PPKoller/MAX31865x10/ArgonCube_2x2/pt100_4-point.jpg

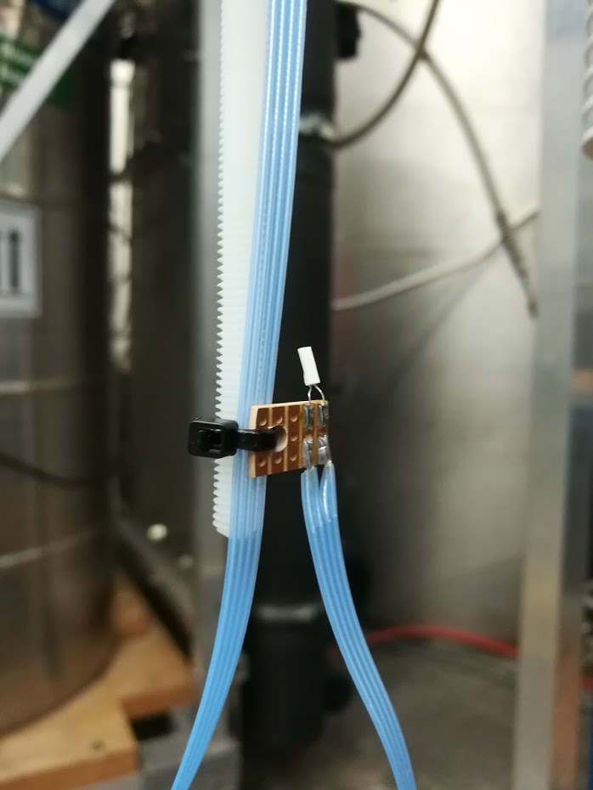
ArgonCube_2x2/pt100_4-point.jpg
