PPKoller/MAX31865x10/ArgonCube_2x2/pt100_backplate_drawings.jpg

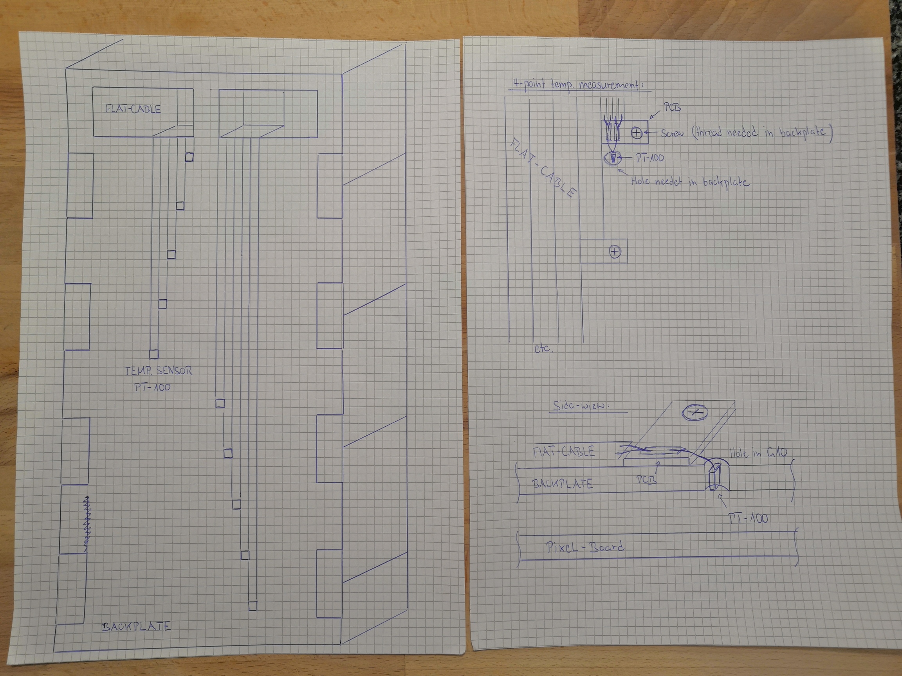
ArgonCube_2x2/pt100_backplate_drawings.jpg
