PPKoller/MAX31865x10/README.md

# MAX31865x10
PCB for serial 4-point measurement of ten PT-100 temperature sensors using Raspberry Pi.
