PPKoller/MAX31865x10/(list of files, cad)

Other CAD files:
Adafruit-MAX31865-PCB/kicad-footprints/Sources/Package_SON/X2SON-4_1x1mm_P0.65mm.fcstd
Adafruit-MAX31865-PCB/kicad-footprints/Sources/Package_TO_SOT_THT/sod-70.fcstd
MAX31865_x10_PCB/kicad-footprints/Sources/Package_SON/X2SON-4_1x1mm_P0.65mm.fcstd
MAX31865_x10_PCB/kicad-footprints/Sources/Package_TO_SOT_THT/sod-70_P5.08mm.fcstd
Adafruit-MAX31865-PCB/kicad-footprints/Sources/Package_TO_SOT_THT/sod-70_P5.08mm.fcstd
MAX31865_x10_PCB/kicad-footprints/Sources/Package_TO_SOT_THT/sod-70.fcstd
