PPKoller/MAX31865x10/MAX31865_x10_PCB/MAX31865_x10_PCB.kicad_pcb

## KiCad design MAX31865_x10_PCB/MAX31865_x10_PCB.kicad_pcb (2020-02-25)

Schematic: power.sch

Parts:
C1, C2: 10uF; 0805-NO
J1: Conn_02x20_Odd_Even; PinHeader_2x20_P2.54mm_Vertical
JP1: Jumper_3_Bridged12; PinHeader_1x03_P2.54mm_Vertical
U1, U2, U3, U4: MOUNTINGHOLE3.0; MountingHole_3.2mm_M3
U5: MIC5225-3.3; SOT23-5

Connections:
CLK_5V: J1.23; also elsewhere on the board
CS0_5V: J1.40; also elsewhere on the board
CS1_5V: J1.38; also elsewhere on the board
CS2_5V: J1.36; also elsewhere on the board
CS3_5V: J1.32; also elsewhere on the board
CS4_5V: J1.26; also elsewhere on the board
CS5_5V: J1.24; also elsewhere on the board
CS6_5V: J1.22; also elsewhere on the board
CS7_5V: J1.18; also elsewhere on the board
CS8_5V: J1.16; also elsewhere on the board
CS9_5V: J1.12; also elsewhere on the board
EXT_3V3: J1.1, JP1.3 (B)
EXT_5V: C1.1, J1.2, U5.1 (IN), U5.3 (EN)
GND: C1.2, C2.2, J1.6, U5.2 (GND); also elsewhere on the board
RDY: J1.15; also elsewhere on the board
SDI_5V: J1.19; also elsewhere on the board
SDO: J1.21; also elsewhere on the board
VDD: C2.1, JP1.1 (A), JP1.2 (C), U5.5 (OUT); also elsewhere on the board

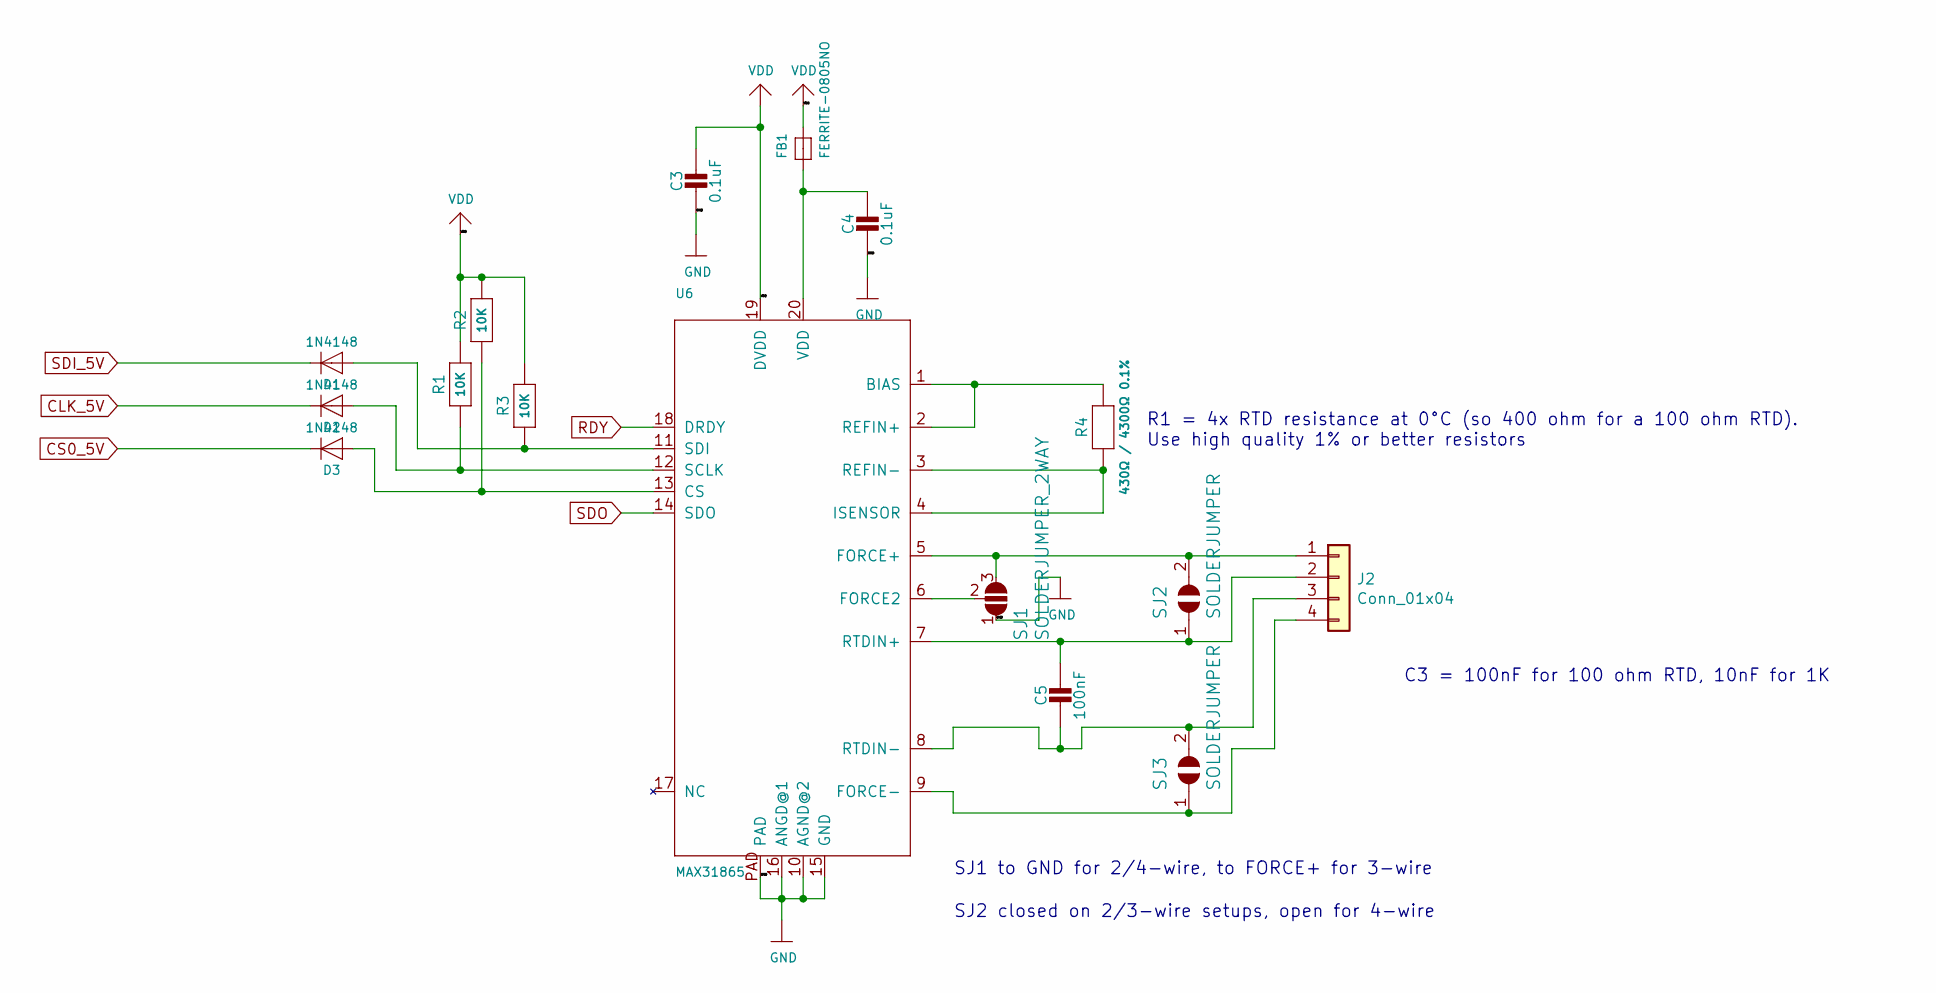
[picture p18: schematic max31865_00.sch]

Parts:
C3, C4: 0.1uF; 0805-NO
C5: 100nF; 0805-NO
D1, D2, D3: 1N4148; SOD-323
FB1: FERRITE-0805NO; 0805-NO
J2: Conn_01x04; TerminalBlock_4Ucon_1x04_P3.50mm_Horizontal
R1, R2, R3: 10K; 0805-NO
R4: 430Ω / 4300Ω 0.1%; 0805-NO
SJ1: SOLDERJUMPER_2WAY; SOLDERJUMPER_2WAY_OPEN_NOPASTE
SJ2, SJ3: SOLDERJUMPER; SOLDERJUMPER_ARROW_NOPASTE
U6: MAX31865; QFN20_4MM_0.65MM

Connections:
CLK_5V: D2.C; also elsewhere on the board
CS0_5V: D3.C; also elsewhere on the board
GND: C3.2, C4.2, SJ1.1, U6.10 (AGND@2), U6.15 (GND), U6.16 (ANGD@1), U6.PAD; also elsewhere on the board
unnamed: C4.1, FB1.1, U6.20 (VDD)
unnamed: C5.1, J2.2, SJ2.1, U6.7 (RTDIN+)
unnamed: C5.2, J2.3, SJ3.2, U6.8 (RTDIN-)
unnamed: D1.A, R3.1, U6.11 (SDI)
unnamed: D2.A, R1.1, U6.12 (SCLK)
unnamed: D3.A, R2.1, U6.13 (CS)
unnamed: J2.1, SJ1.3, SJ2.2, U6.5 (FORCE+)
unnamed: J2.4, SJ3.1, U6.9 (FORCE-)
unnamed: R4.1, U6.3 (REFIN-), U6.4 (ISENSOR)
unnamed: R4.2, U6.1 (BIAS), U6.2 (REFIN+)
unnamed: SJ1.2, U6.6 (FORCE2)
RDY: U6.18 (DRDY); also elsewhere on the board
SDI_5V: D1.C; also elsewhere on the board
SDO: U6.14 (SDO); also elsewhere on the board
VDD: C3.1, FB1.2, R1.2, R2.2, R3.2, U6.19 (DVDD); also elsewhere on the board

Notes on the sheet:
C3 = 100nF for 100 ohm RTD, 10nF for 1K
R1 = 4x RTD resistance at 0°C (so 400 ohm for a 100 ohm RTD). Use high quality 1% or better resistors
SJ1 to GND for 2/4-wire, to FORCE+ for 3-wire
SJ2 closed on 2/3-wire setups, open for 4-wire

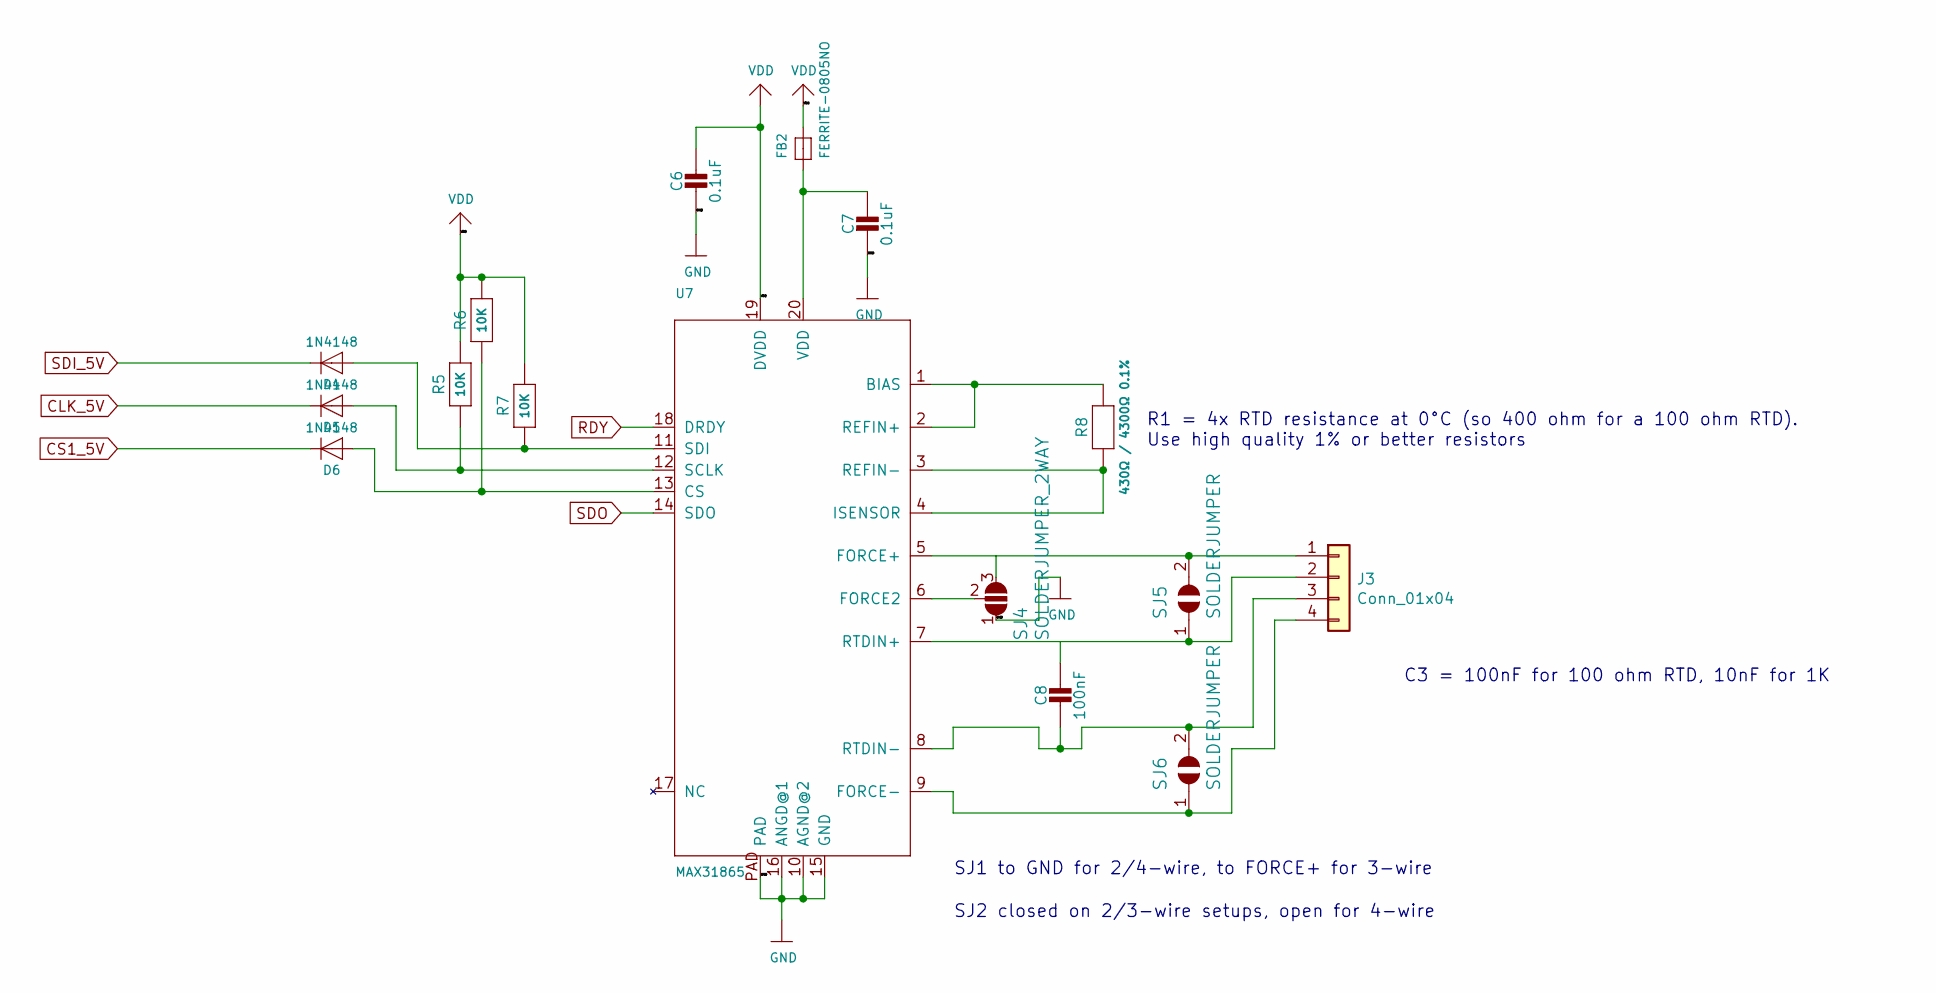
[picture p19: schematic max31865_01.sch]

Parts:
C6, C7: 0.1uF; 0805-NO
C8: 100nF; 0805-NO
D4, D5, D6: 1N4148; SOD-323
FB2: FERRITE-0805NO; 0805-NO
J3: Conn_01x04; TerminalBlock_4Ucon_1x04_P3.50mm_Horizontal
R5, R6, R7: 10K; 0805-NO
R8: 430Ω / 4300Ω 0.1%; 0805-NO
SJ4: SOLDERJUMPER_2WAY; SOLDERJUMPER_2WAY_OPEN_NOPASTE
SJ5, SJ6: SOLDERJUMPER; SOLDERJUMPER_ARROW_NOPASTE
U7: MAX31865; QFN20_4MM_0.65MM

Connections:
CLK_5V: D5.C; also elsewhere on the board
CS1_5V: D6.C; also elsewhere on the board
GND: C6.2, C7.2, SJ4.1, U7.10 (AGND@2), U7.15 (GND), U7.16 (ANGD@1), U7.PAD; also elsewhere on the board
unnamed: C7.1, FB2.1, U7.20 (VDD)
unnamed: C8.1, J3.2, SJ5.1, U7.7 (RTDIN+)
unnamed: C8.2, J3.3, SJ6.2, U7.8 (RTDIN-)
unnamed: D4.A, R7.1, U7.11 (SDI)
unnamed: D5.A, R5.1, U7.12 (SCLK)
unnamed: D6.A, R6.1, U7.13 (CS)
unnamed: J3.1, SJ4.3, SJ5.2, U7.5 (FORCE+)
unnamed: J3.4, SJ6.1, U7.9 (FORCE-)
unnamed: R8.1, U7.3 (REFIN-), U7.4 (ISENSOR)
unnamed: R8.2, U7.1 (BIAS), U7.2 (REFIN+)
unnamed: SJ4.2, U7.6 (FORCE2)
RDY: U7.18 (DRDY); also elsewhere on the board
SDI_5V: D4.C; also elsewhere on the board
SDO: U7.14 (SDO); also elsewhere on the board
VDD: C6.1, FB2.2, R5.2, R6.2, R7.2, U7.19 (DVDD); also elsewhere on the board

Notes on the sheet:
C3 = 100nF for 100 ohm RTD, 10nF for 1K
R1 = 4x RTD resistance at 0°C (so 400 ohm for a 100 ohm RTD). Use high quality 1% or better resistors
SJ1 to GND for 2/4-wire, to FORCE+ for 3-wire
SJ2 closed on 2/3-wire setups, open for 4-wire

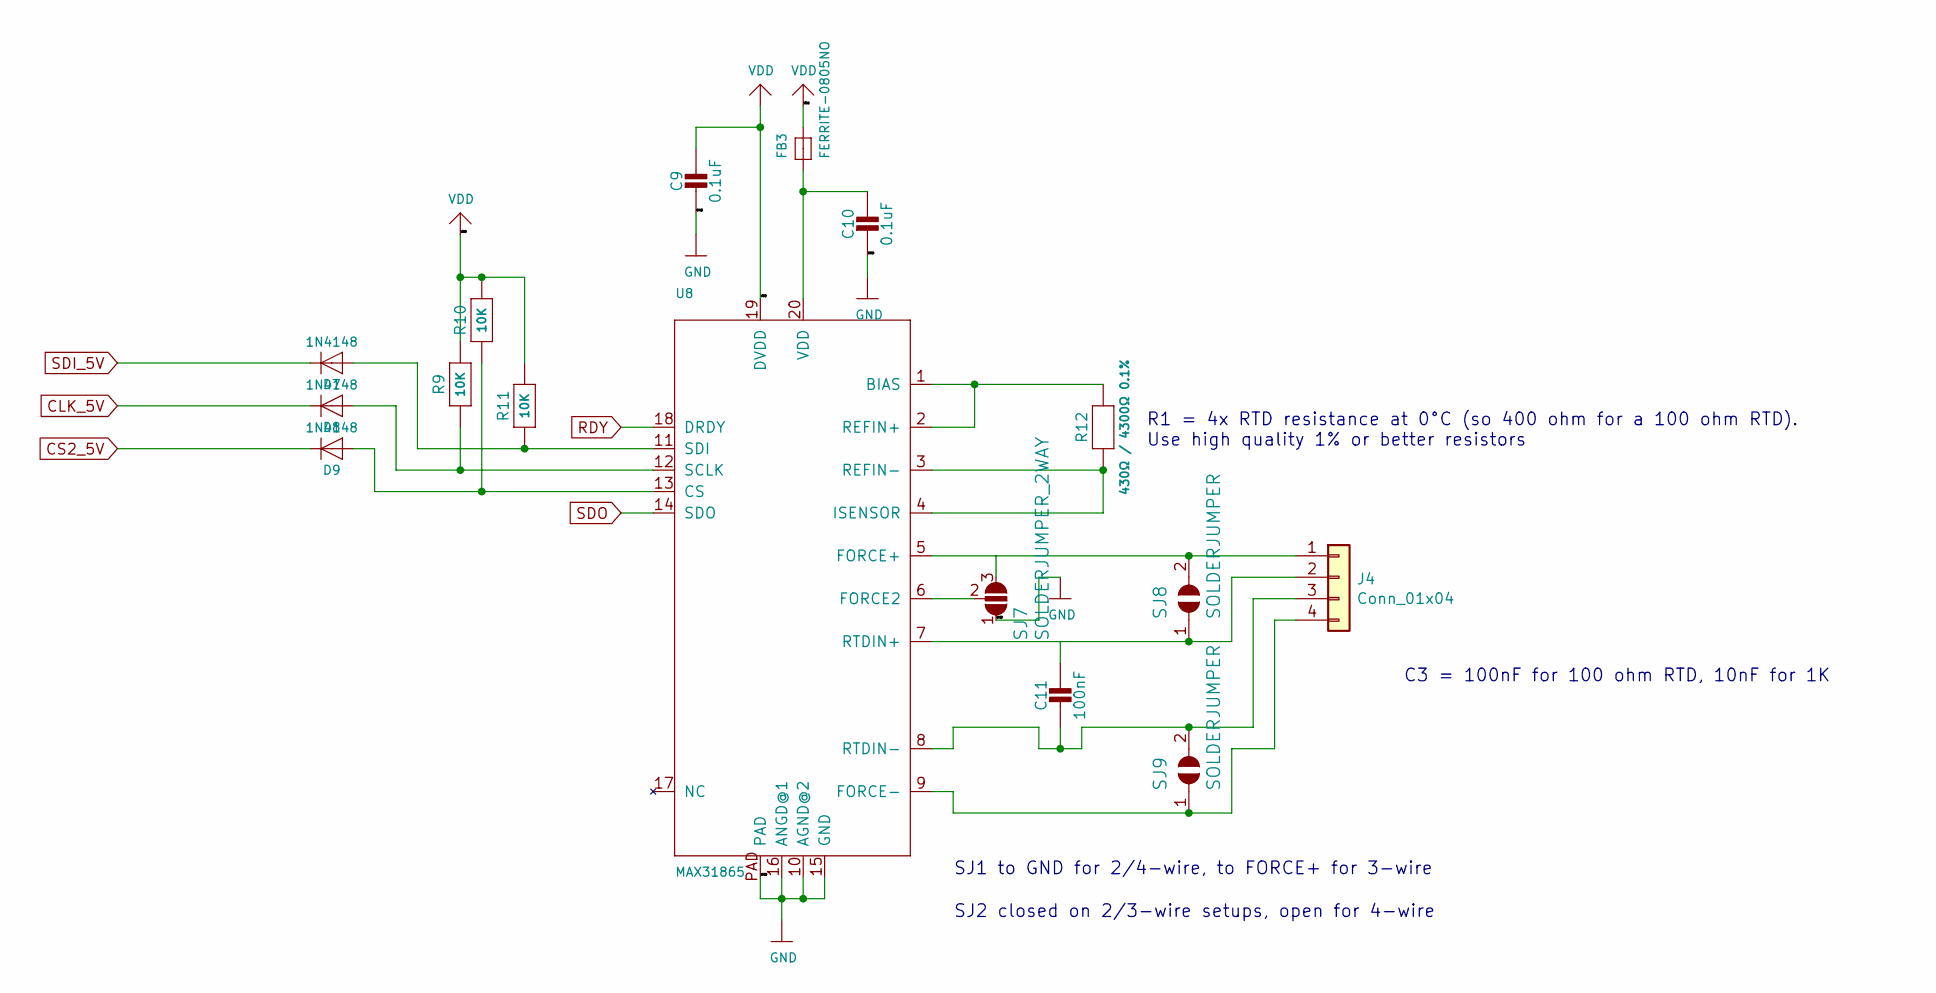
[picture p20: schematic max31865_02.sch]

Parts:
C9, C10: 0.1uF; 0805-NO
C11: 100nF; 0805-NO
D7, D8, D9: 1N4148; SOD-323
FB3: FERRITE-0805NO; 0805-NO
J4: Conn_01x04; TerminalBlock_4Ucon_1x04_P3.50mm_Horizontal
R9, R10, R11: 10K; 0805-NO
R12: 430Ω / 4300Ω 0.1%; 0805-NO
SJ7: SOLDERJUMPER_2WAY; SOLDERJUMPER_2WAY_OPEN_NOPASTE
SJ8, SJ9: SOLDERJUMPER; SOLDERJUMPER_ARROW_NOPASTE
U8: MAX31865; QFN20_4MM_0.65MM

Connections:
CLK_5V: D8.C; also elsewhere on the board
CS2_5V: D9.C; also elsewhere on the board
GND: C9.2, C10.2, SJ7.1, U8.10 (AGND@2), U8.15 (GND), U8.16 (ANGD@1), U8.PAD; also elsewhere on the board
unnamed: C10.1, FB3.1, U8.20 (VDD)
unnamed: C11.1, J4.2, SJ8.1, U8.7 (RTDIN+)
unnamed: C11.2, J4.3, SJ9.2, U8.8 (RTDIN-)
unnamed: D7.A, R11.1, U8.11 (SDI)
unnamed: D8.A, R9.1, U8.12 (SCLK)
unnamed: D9.A, R10.1, U8.13 (CS)
unnamed: J4.1, SJ7.3, SJ8.2, U8.5 (FORCE+)
unnamed: J4.4, SJ9.1, U8.9 (FORCE-)
unnamed: R12.1, U8.3 (REFIN-), U8.4 (ISENSOR)
unnamed: R12.2, U8.1 (BIAS), U8.2 (REFIN+)
unnamed: SJ7.2, U8.6 (FORCE2)
RDY: U8.18 (DRDY); also elsewhere on the board
SDI_5V: D7.C; also elsewhere on the board
SDO: U8.14 (SDO); also elsewhere on the board
VDD: C9.1, FB3.2, R9.2, R10.2, R11.2, U8.19 (DVDD); also elsewhere on the board

Notes on the sheet:
C3 = 100nF for 100 ohm RTD, 10nF for 1K
R1 = 4x RTD resistance at 0°C (so 400 ohm for a 100 ohm RTD). Use high quality 1% or better resistors
SJ1 to GND for 2/4-wire, to FORCE+ for 3-wire
SJ2 closed on 2/3-wire setups, open for 4-wire

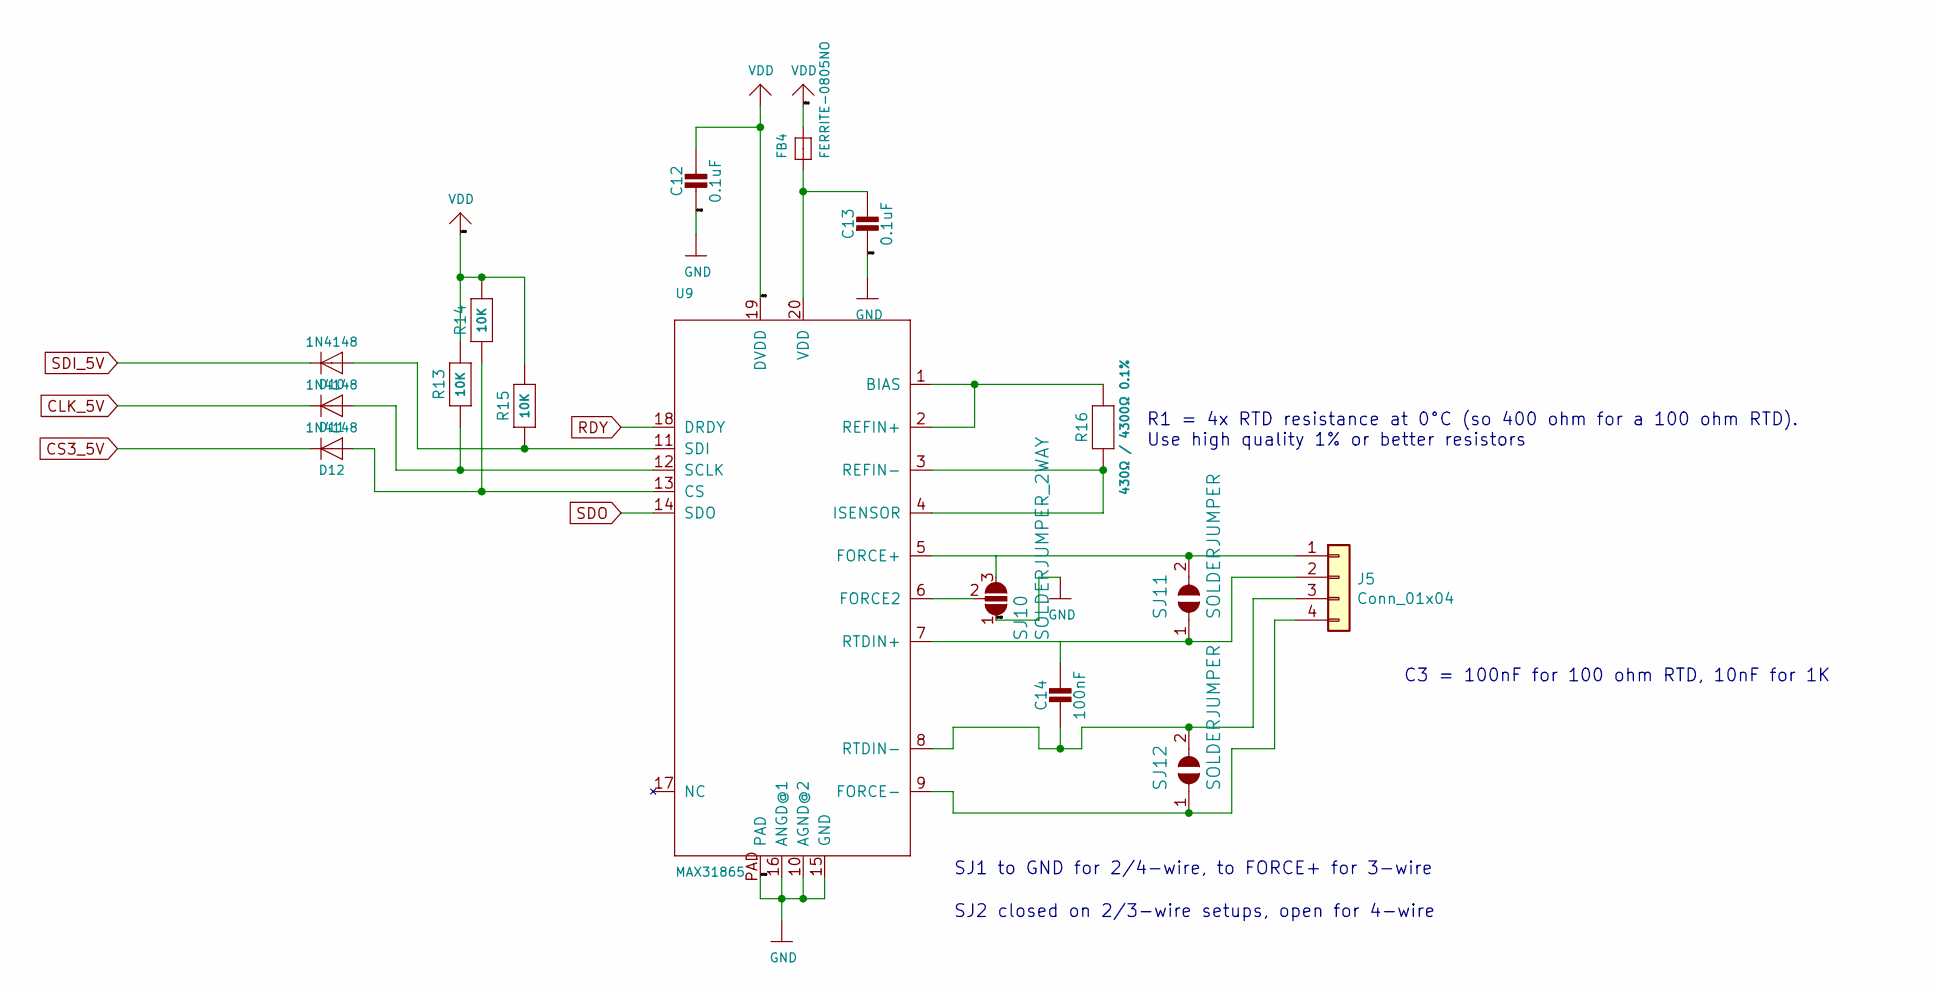
[picture p21: schematic max31865_03.sch]

Parts:
C12, C13: 0.1uF; 0805-NO
C14: 100nF; 0805-NO
D10, D11, D12: 1N4148; SOD-323
FB4: FERRITE-0805NO; 0805-NO
J5: Conn_01x04; TerminalBlock_4Ucon_1x04_P3.50mm_Horizontal
R13, R14, R15: 10K; 0805-NO
R16: 430Ω / 4300Ω 0.1%; 0805-NO
SJ10: SOLDERJUMPER_2WAY; SOLDERJUMPER_2WAY_OPEN_NOPASTE
SJ11, SJ12: SOLDERJUMPER; SOLDERJUMPER_ARROW_NOPASTE
U9: MAX31865; QFN20_4MM_0.65MM

Connections:
CLK_5V: D11.C; also elsewhere on the board
CS3_5V: D12.C; also elsewhere on the board
GND: C12.2, C13.2, SJ10.1, U9.10 (AGND@2), U9.15 (GND), U9.16 (ANGD@1), U9.PAD; also elsewhere on the board
unnamed: C13.1, FB4.1, U9.20 (VDD)
unnamed: C14.1, J5.2, SJ11.1, U9.7 (RTDIN+)
unnamed: C14.2, J5.3, SJ12.2, U9.8 (RTDIN-)
unnamed: D10.A, R15.1, U9.11 (SDI)
unnamed: D11.A, R13.1, U9.12 (SCLK)
unnamed: D12.A, R14.1, U9.13 (CS)
unnamed: J5.1, SJ10.3, SJ11.2, U9.5 (FORCE+)
unnamed: J5.4, SJ12.1, U9.9 (FORCE-)
unnamed: R16.1, U9.3 (REFIN-), U9.4 (ISENSOR)
unnamed: R16.2, U9.1 (BIAS), U9.2 (REFIN+)
unnamed: SJ10.2, U9.6 (FORCE2)
RDY: U9.18 (DRDY); also elsewhere on the board
SDI_5V: D10.C; also elsewhere on the board
SDO: U9.14 (SDO); also elsewhere on the board
VDD: C12.1, FB4.2, R13.2, R14.2, R15.2, U9.19 (DVDD); also elsewhere on the board

Notes on the sheet:
C3 = 100nF for 100 ohm RTD, 10nF for 1K
R1 = 4x RTD resistance at 0°C (so 400 ohm for a 100 ohm RTD). Use high quality 1% or better resistors
SJ1 to GND for 2/4-wire, to FORCE+ for 3-wire
SJ2 closed on 2/3-wire setups, open for 4-wire

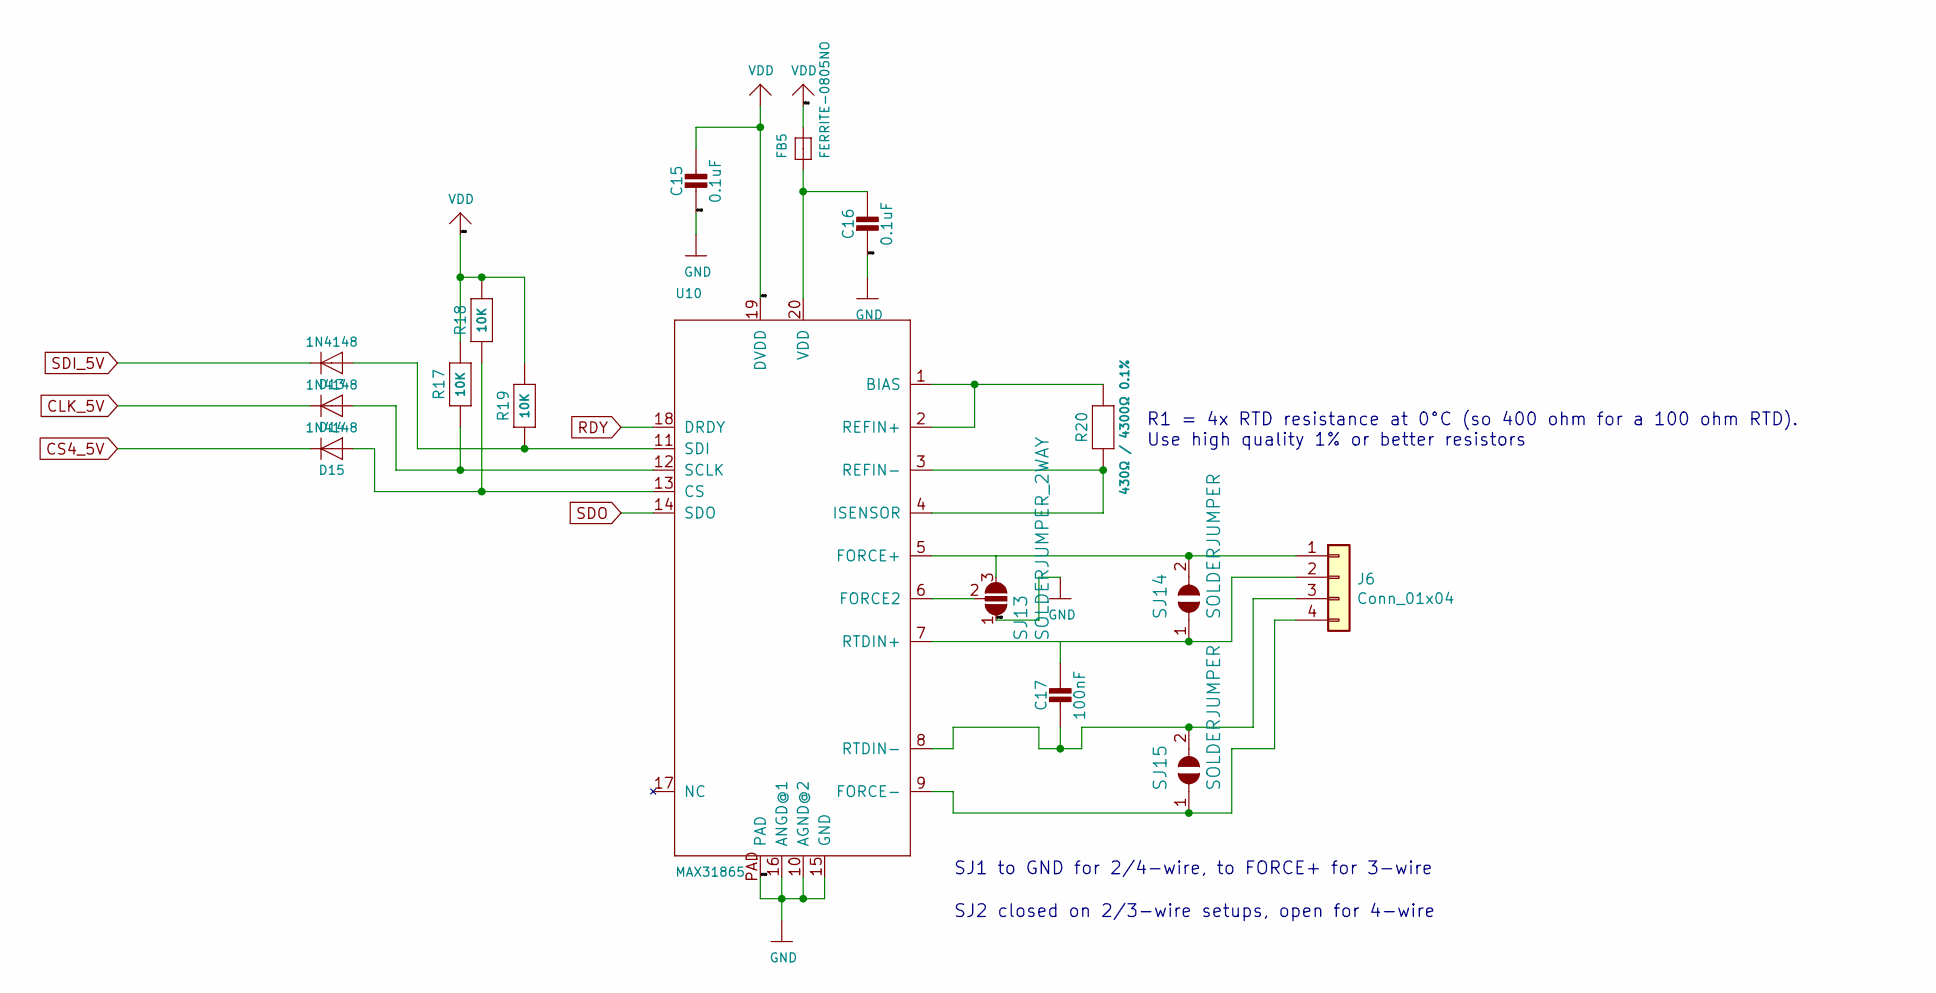
[picture p22: schematic max31865_04.sch]

Parts:
C15, C16: 0.1uF; 0805-NO
C17: 100nF; 0805-NO
D13, D14, D15: 1N4148; SOD-323
FB5: FERRITE-0805NO; 0805-NO
J6: Conn_01x04; TerminalBlock_4Ucon_1x04_P3.50mm_Horizontal
R17, R18, R19: 10K; 0805-NO
R20: 430Ω / 4300Ω 0.1%; 0805-NO
SJ13: SOLDERJUMPER_2WAY; SOLDERJUMPER_2WAY_OPEN_NOPASTE
SJ14, SJ15: SOLDERJUMPER; SOLDERJUMPER_ARROW_NOPASTE
U10: MAX31865; QFN20_4MM_0.65MM

Connections:
CLK_5V: D14.C; also elsewhere on the board
CS4_5V: D15.C; also elsewhere on the board
GND: C15.2, C16.2, SJ13.1, U10.10 (AGND@2), U10.15 (GND), U10.16 (ANGD@1), U10.PAD; also elsewhere on the board
unnamed: C16.1, FB5.1, U10.20 (VDD)
unnamed: C17.1, J6.2, SJ14.1, U10.7 (RTDIN+)
unnamed: C17.2, J6.3, SJ15.2, U10.8 (RTDIN-)
unnamed: D13.A, R19.1, U10.11 (SDI)
unnamed: D14.A, R17.1, U10.12 (SCLK)
unnamed: D15.A, R18.1, U10.13 (CS)
unnamed: J6.1, SJ13.3, SJ14.2, U10.5 (FORCE+)
unnamed: J6.4, SJ15.1, U10.9 (FORCE-)
unnamed: R20.1, U10.3 (REFIN-), U10.4 (ISENSOR)
unnamed: R20.2, U10.1 (BIAS), U10.2 (REFIN+)
unnamed: SJ13.2, U10.6 (FORCE2)
RDY: U10.18 (DRDY); also elsewhere on the board
SDI_5V: D13.C; also elsewhere on the board
SDO: U10.14 (SDO); also elsewhere on the board
VDD: C15.1, FB5.2, R17.2, R18.2, R19.2, U10.19 (DVDD); also elsewhere on the board

Notes on the sheet:
R1 = 4x RTD resistance at 0°C (so 400 ohm for a 100 ohm RTD). Use high quality 1% or better resistors
SJ1 to GND for 2/4-wire, to FORCE+ for 3-wire
SJ2 closed on 2/3-wire setups, open for 4-wire

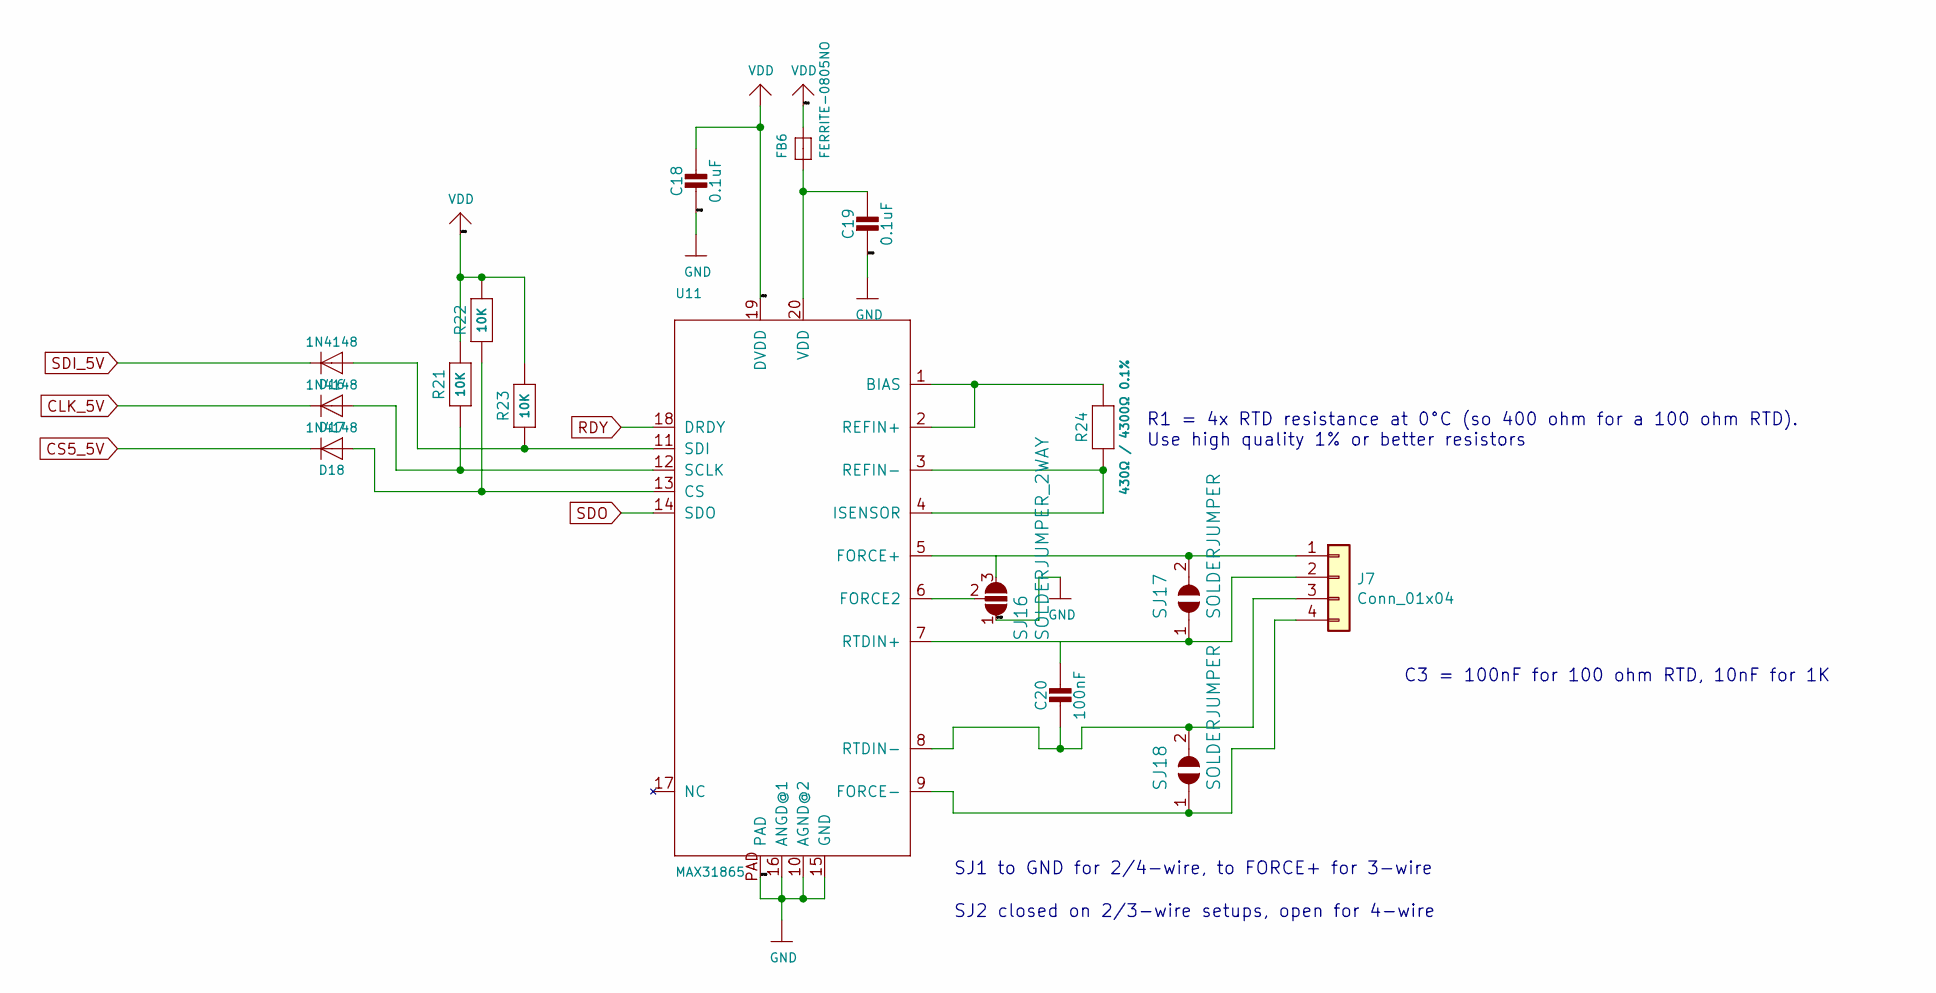
[picture p23: schematic max31865_05.sch]

Parts:
C18, C19: 0.1uF; 0805-NO
C20: 100nF; 0805-NO
D16, D17, D18: 1N4148; SOD-323
FB6: FERRITE-0805NO; 0805-NO
J7: Conn_01x04; TerminalBlock_4Ucon_1x04_P3.50mm_Horizontal
R21, R22, R23: 10K; 0805-NO
R24: 430Ω / 4300Ω 0.1%; 0805-NO
SJ16: SOLDERJUMPER_2WAY; SOLDERJUMPER_2WAY_OPEN_NOPASTE
SJ17, SJ18: SOLDERJUMPER; SOLDERJUMPER_ARROW_NOPASTE
U11: MAX31865; QFN20_4MM_0.65MM

Connections:
CLK_5V: D17.C; also elsewhere on the board
CS5_5V: D18.C; also elsewhere on the board
GND: C18.2, C19.2, SJ16.1, U11.10 (AGND@2), U11.15 (GND), U11.16 (ANGD@1), U11.PAD; also elsewhere on the board
unnamed: C19.1, FB6.1, U11.20 (VDD)
unnamed: C20.1, J7.2, SJ17.1, U11.7 (RTDIN+)
unnamed: C20.2, J7.3, SJ18.2, U11.8 (RTDIN-)
unnamed: D16.A, R23.1, U11.11 (SDI)
unnamed: D17.A, R21.1, U11.12 (SCLK)
unnamed: D18.A, R22.1, U11.13 (CS)
unnamed: J7.1, SJ16.3, SJ17.2, U11.5 (FORCE+)
unnamed: J7.4, SJ18.1, U11.9 (FORCE-)
unnamed: R24.1, U11.3 (REFIN-), U11.4 (ISENSOR)
unnamed: R24.2, U11.1 (BIAS), U11.2 (REFIN+)
unnamed: SJ16.2, U11.6 (FORCE2)
RDY: U11.18 (DRDY); also elsewhere on the board
SDI_5V: D16.C; also elsewhere on the board
SDO: U11.14 (SDO); also elsewhere on the board
VDD: C18.1, FB6.2, R21.2, R22.2, R23.2, U11.19 (DVDD); also elsewhere on the board

Notes on the sheet:
C3 = 100nF for 100 ohm RTD, 10nF for 1K
R1 = 4x RTD resistance at 0°C (so 400 ohm for a 100 ohm RTD). Use high quality 1% or better resistors
SJ1 to GND for 2/4-wire, to FORCE+ for 3-wire
SJ2 closed on 2/3-wire setups, open for 4-wire

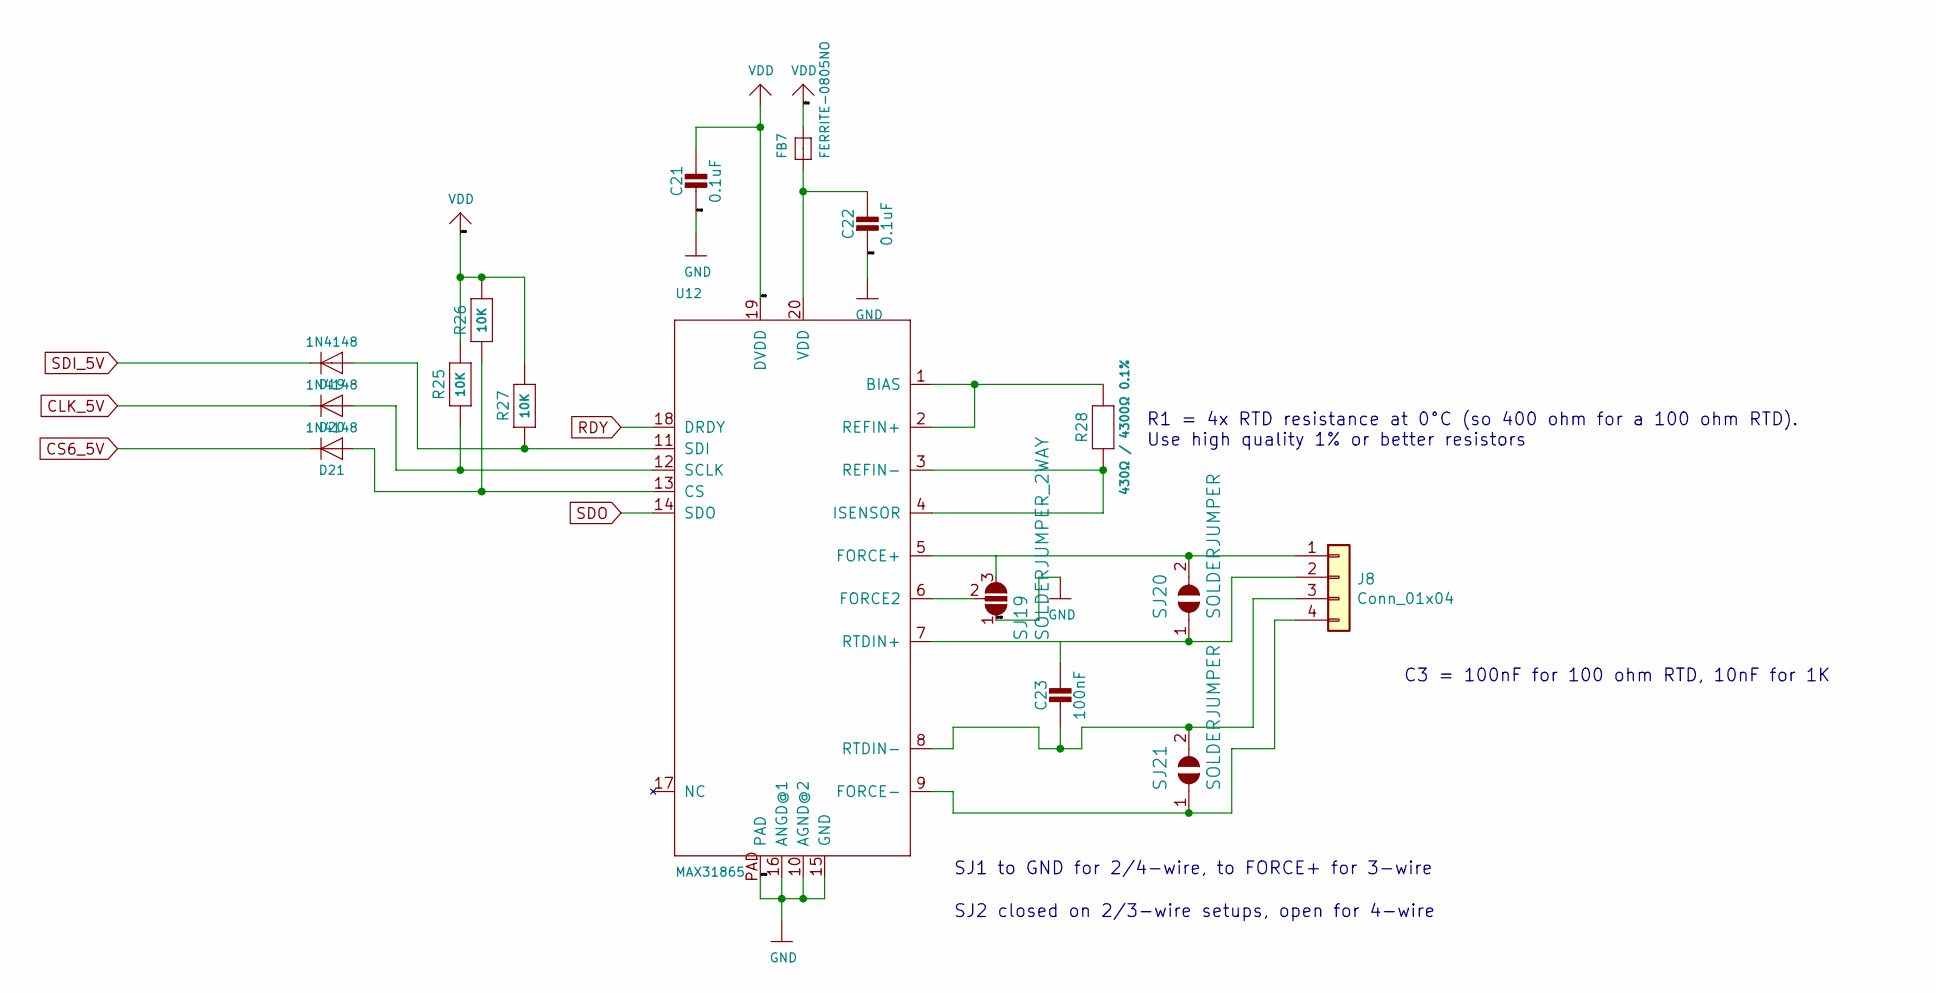
[picture p24: schematic max31865_06.sch]

Parts:
C21, C22: 0.1uF; 0805-NO
C23: 100nF; 0805-NO
D19, D20, D21: 1N4148; SOD-323
FB7: FERRITE-0805NO; 0805-NO
J8: Conn_01x04; TerminalBlock_4Ucon_1x04_P3.50mm_Horizontal
R25, R26, R27: 10K; 0805-NO
R28: 430Ω / 4300Ω 0.1%; 0805-NO
SJ19: SOLDERJUMPER_2WAY; SOLDERJUMPER_2WAY_OPEN_NOPASTE
SJ20, SJ21: SOLDERJUMPER; SOLDERJUMPER_ARROW_NOPASTE
U12: MAX31865; QFN20_4MM_0.65MM

Connections:
CLK_5V: D20.C; also elsewhere on the board
CS6_5V: D21.C; also elsewhere on the board
GND: C21.2, C22.2, SJ19.1, U12.10 (AGND@2), U12.15 (GND), U12.16 (ANGD@1), U12.PAD; also elsewhere on the board
unnamed: C22.1, FB7.1, U12.20 (VDD)
unnamed: C23.1, J8.2, SJ20.1, U12.7 (RTDIN+)
unnamed: C23.2, J8.3, SJ21.2, U12.8 (RTDIN-)
unnamed: D19.A, R27.1, U12.11 (SDI)
unnamed: D20.A, R25.1, U12.12 (SCLK)
unnamed: D21.A, R26.1, U12.13 (CS)
unnamed: J8.1, SJ19.3, SJ20.2, U12.5 (FORCE+)
unnamed: J8.4, SJ21.1, U12.9 (FORCE-)
unnamed: R28.1, U12.3 (REFIN-), U12.4 (ISENSOR)
unnamed: R28.2, U12.1 (BIAS), U12.2 (REFIN+)
unnamed: SJ19.2, U12.6 (FORCE2)
RDY: U12.18 (DRDY); also elsewhere on the board
SDI_5V: D19.C; also elsewhere on the board
SDO: U12.14 (SDO); also elsewhere on the board
VDD: C21.1, FB7.2, R25.2, R26.2, R27.2, U12.19 (DVDD); also elsewhere on the board

Notes on the sheet:
C3 = 100nF for 100 ohm RTD, 10nF for 1K
R1 = 4x RTD resistance at 0°C (so 400 ohm for a 100 ohm RTD). Use high quality 1% or better resistors
SJ1 to GND for 2/4-wire, to FORCE+ for 3-wire
SJ2 closed on 2/3-wire setups, open for 4-wire

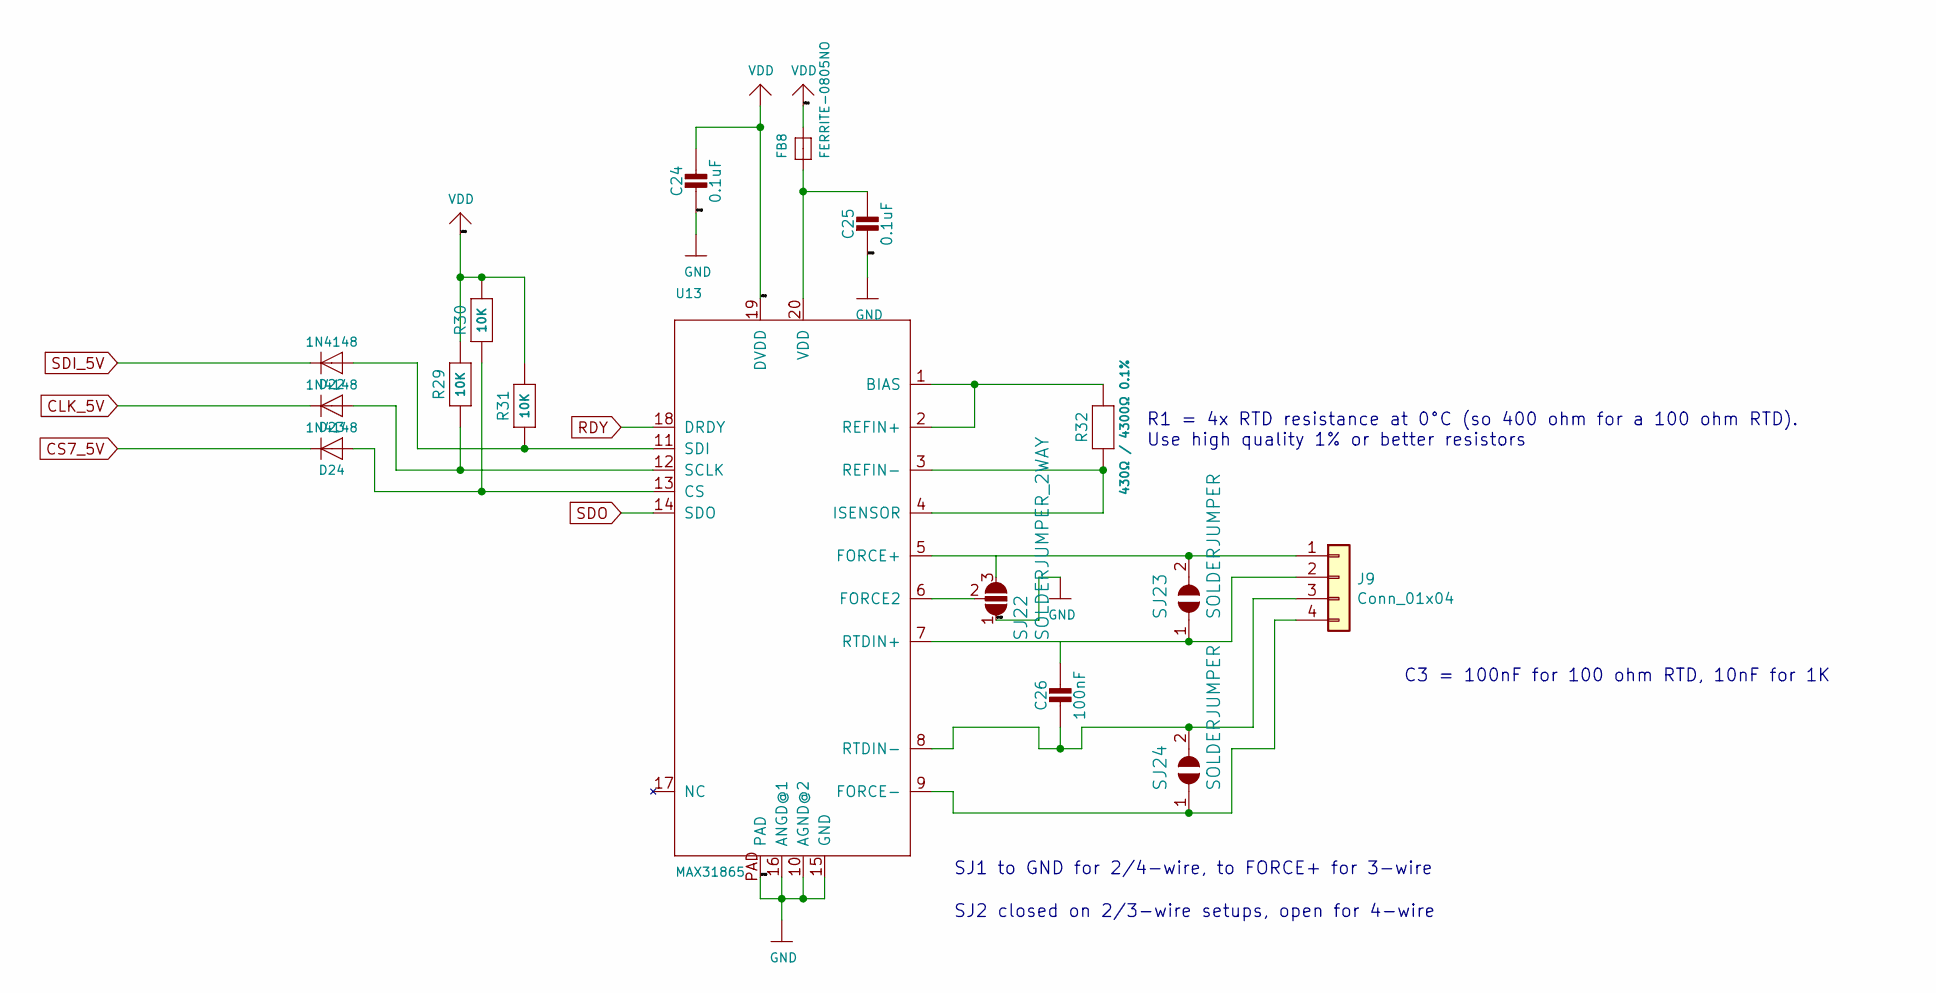
[picture p25: schematic max31865_07.sch]

Parts:
C24, C25: 0.1uF; 0805-NO
C26: 100nF; 0805-NO
D22, D23, D24: 1N4148; SOD-323
FB8: FERRITE-0805NO; 0805-NO
J9: Conn_01x04; TerminalBlock_4Ucon_1x04_P3.50mm_Horizontal
R29, R30, R31: 10K; 0805-NO
R32: 430Ω / 4300Ω 0.1%; 0805-NO
SJ22: SOLDERJUMPER_2WAY; SOLDERJUMPER_2WAY_OPEN_NOPASTE
SJ23, SJ24: SOLDERJUMPER; SOLDERJUMPER_ARROW_NOPASTE
U13: MAX31865; QFN20_4MM_0.65MM

Connections:
CLK_5V: D23.C; also elsewhere on the board
CS7_5V: D24.C; also elsewhere on the board
GND: C24.2, C25.2, SJ22.1, U13.10 (AGND@2), U13.15 (GND), U13.16 (ANGD@1), U13.PAD; also elsewhere on the board
unnamed: C25.1, FB8.1, U13.20 (VDD)
unnamed: C26.1, J9.2, SJ23.1, U13.7 (RTDIN+)
unnamed: C26.2, J9.3, SJ24.2, U13.8 (RTDIN-)
unnamed: D22.A, R31.1, U13.11 (SDI)
unnamed: D23.A, R29.1, U13.12 (SCLK)
unnamed: D24.A, R30.1, U13.13 (CS)
unnamed: J9.1, SJ22.3, SJ23.2, U13.5 (FORCE+)
unnamed: J9.4, SJ24.1, U13.9 (FORCE-)
unnamed: R32.1, U13.3 (REFIN-), U13.4 (ISENSOR)
unnamed: R32.2, U13.1 (BIAS), U13.2 (REFIN+)
unnamed: SJ22.2, U13.6 (FORCE2)
RDY: U13.18 (DRDY); also elsewhere on the board
SDI_5V: D22.C; also elsewhere on the board
SDO: U13.14 (SDO); also elsewhere on the board
VDD: C24.1, FB8.2, R29.2, R30.2, R31.2, U13.19 (DVDD); also elsewhere on the board

Notes on the sheet:
C3 = 100nF for 100 ohm RTD, 10nF for 1K
R1 = 4x RTD resistance at 0°C (so 400 ohm for a 100 ohm RTD). Use high quality 1% or better resistors
SJ1 to GND for 2/4-wire, to FORCE+ for 3-wire
SJ2 closed on 2/3-wire setups, open for 4-wire
