PPKoller/MAX31865x10/MAX31865_x10_PCB/MAX31865_x10_PCB.kicad_pcb

## KiCad design MAX31865_x10_PCB/MAX31865_x10_PCB.kicad_pcb (continued)

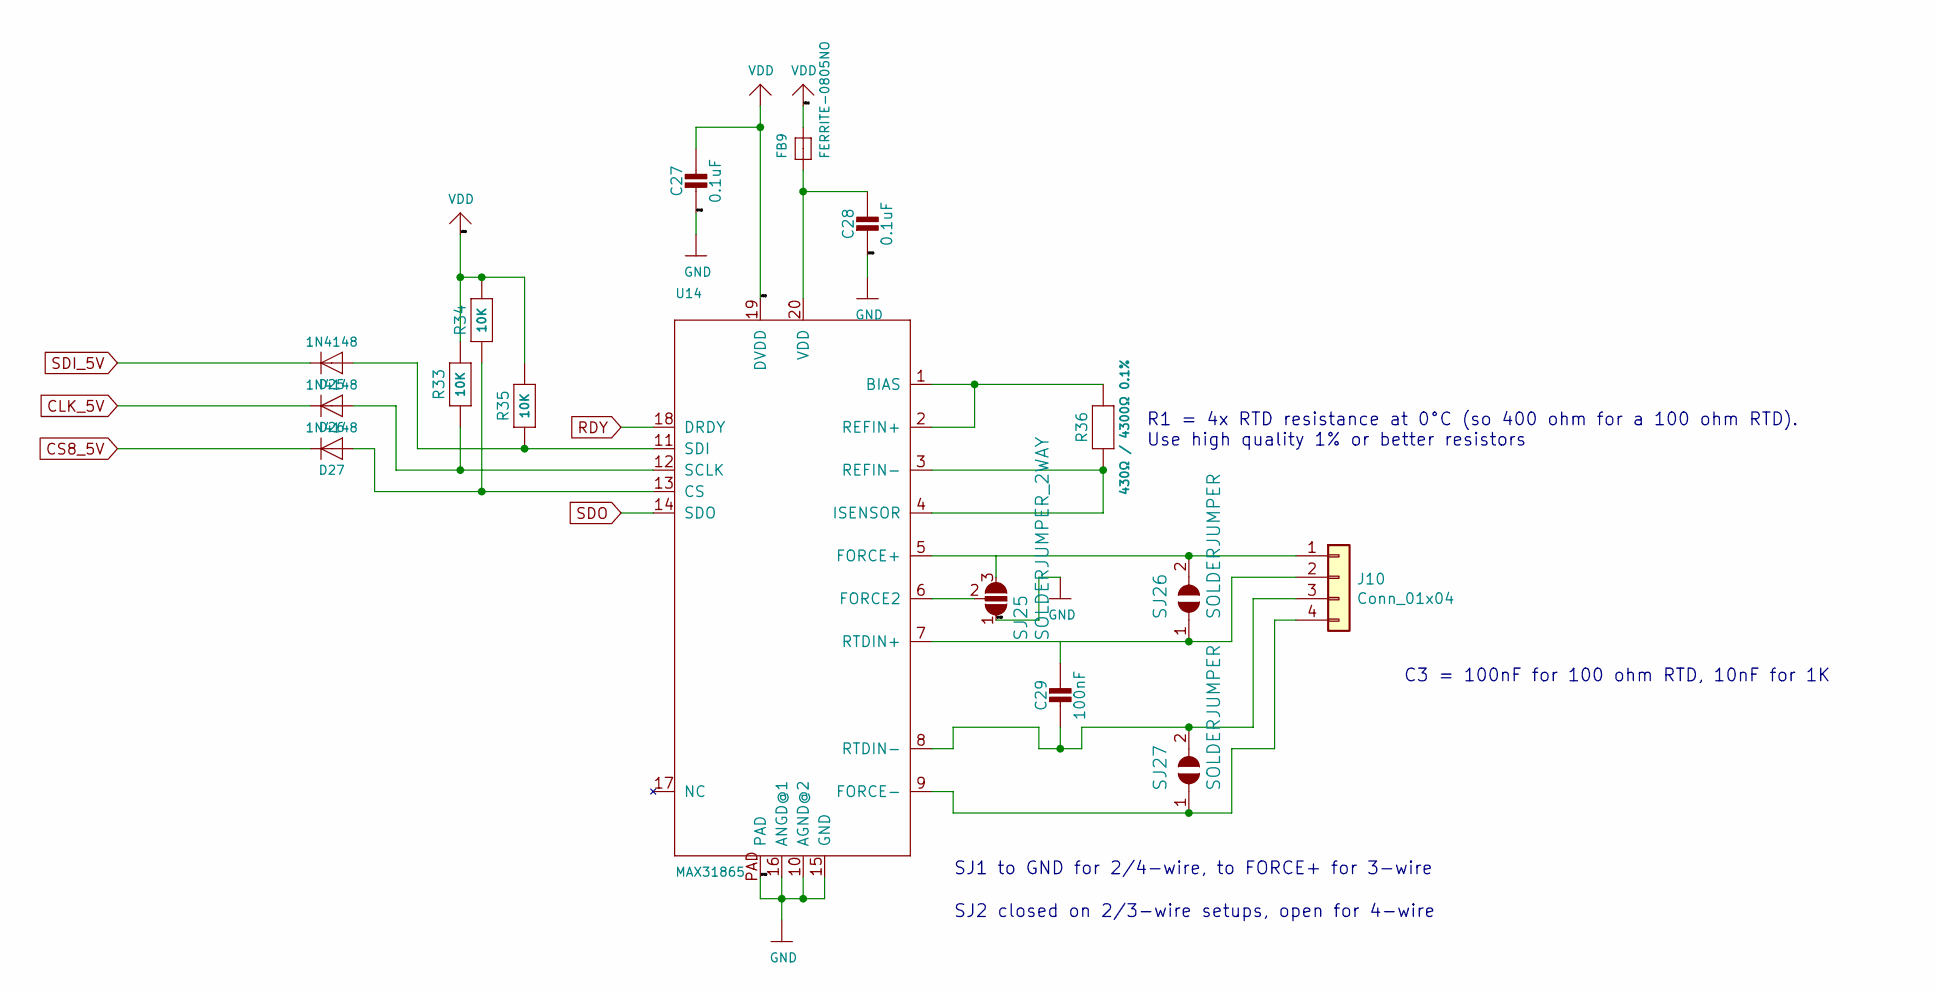
[picture p26: schematic max31865_08.sch]

Parts:
C27, C28: 0.1uF; 0805-NO
C29: 100nF; 0805-NO
D25, D26, D27: 1N4148; SOD-323
FB9: FERRITE-0805NO; 0805-NO
J10: Conn_01x04; TerminalBlock_4Ucon_1x04_P3.50mm_Horizontal
R33, R34, R35: 10K; 0805-NO
R36: 430Ω / 4300Ω 0.1%; 0805-NO
SJ25: SOLDERJUMPER_2WAY; SOLDERJUMPER_2WAY_OPEN_NOPASTE
SJ26, SJ27: SOLDERJUMPER; SOLDERJUMPER_ARROW_NOPASTE
U14: MAX31865; QFN20_4MM_0.65MM

Connections:
CLK_5V: D26.C; also elsewhere on the board
CS8_5V: D27.C; also elsewhere on the board
GND: C27.2, C28.2, SJ25.1, U14.10 (AGND@2), U14.15 (GND), U14.16 (ANGD@1), U14.PAD; also elsewhere on the board
unnamed: C28.1, FB9.1, U14.20 (VDD)
unnamed: C29.1, J10.2, SJ26.1, U14.7 (RTDIN+)
unnamed: C29.2, J10.3, SJ27.2, U14.8 (RTDIN-)
unnamed: D25.A, R35.1, U14.11 (SDI)
unnamed: D26.A, R33.1, U14.12 (SCLK)
unnamed: D27.A, R34.1, U14.13 (CS)
unnamed: J10.1, SJ25.3, SJ26.2, U14.5 (FORCE+)
unnamed: J10.4, SJ27.1, U14.9 (FORCE-)
unnamed: R36.1, U14.3 (REFIN-), U14.4 (ISENSOR)
unnamed: R36.2, U14.1 (BIAS), U14.2 (REFIN+)
unnamed: SJ25.2, U14.6 (FORCE2)
RDY: U14.18 (DRDY); also elsewhere on the board
SDI_5V: D25.C; also elsewhere on the board
SDO: U14.14 (SDO); also elsewhere on the board
VDD: C27.1, FB9.2, R33.2, R34.2, R35.2, U14.19 (DVDD); also elsewhere on the board

Notes on the sheet:
C3 = 100nF for 100 ohm RTD, 10nF for 1K
R1 = 4x RTD resistance at 0°C (so 400 ohm for a 100 ohm RTD). Use high quality 1% or better resistors
SJ1 to GND for 2/4-wire, to FORCE+ for 3-wire
SJ2 closed on 2/3-wire setups, open for 4-wire

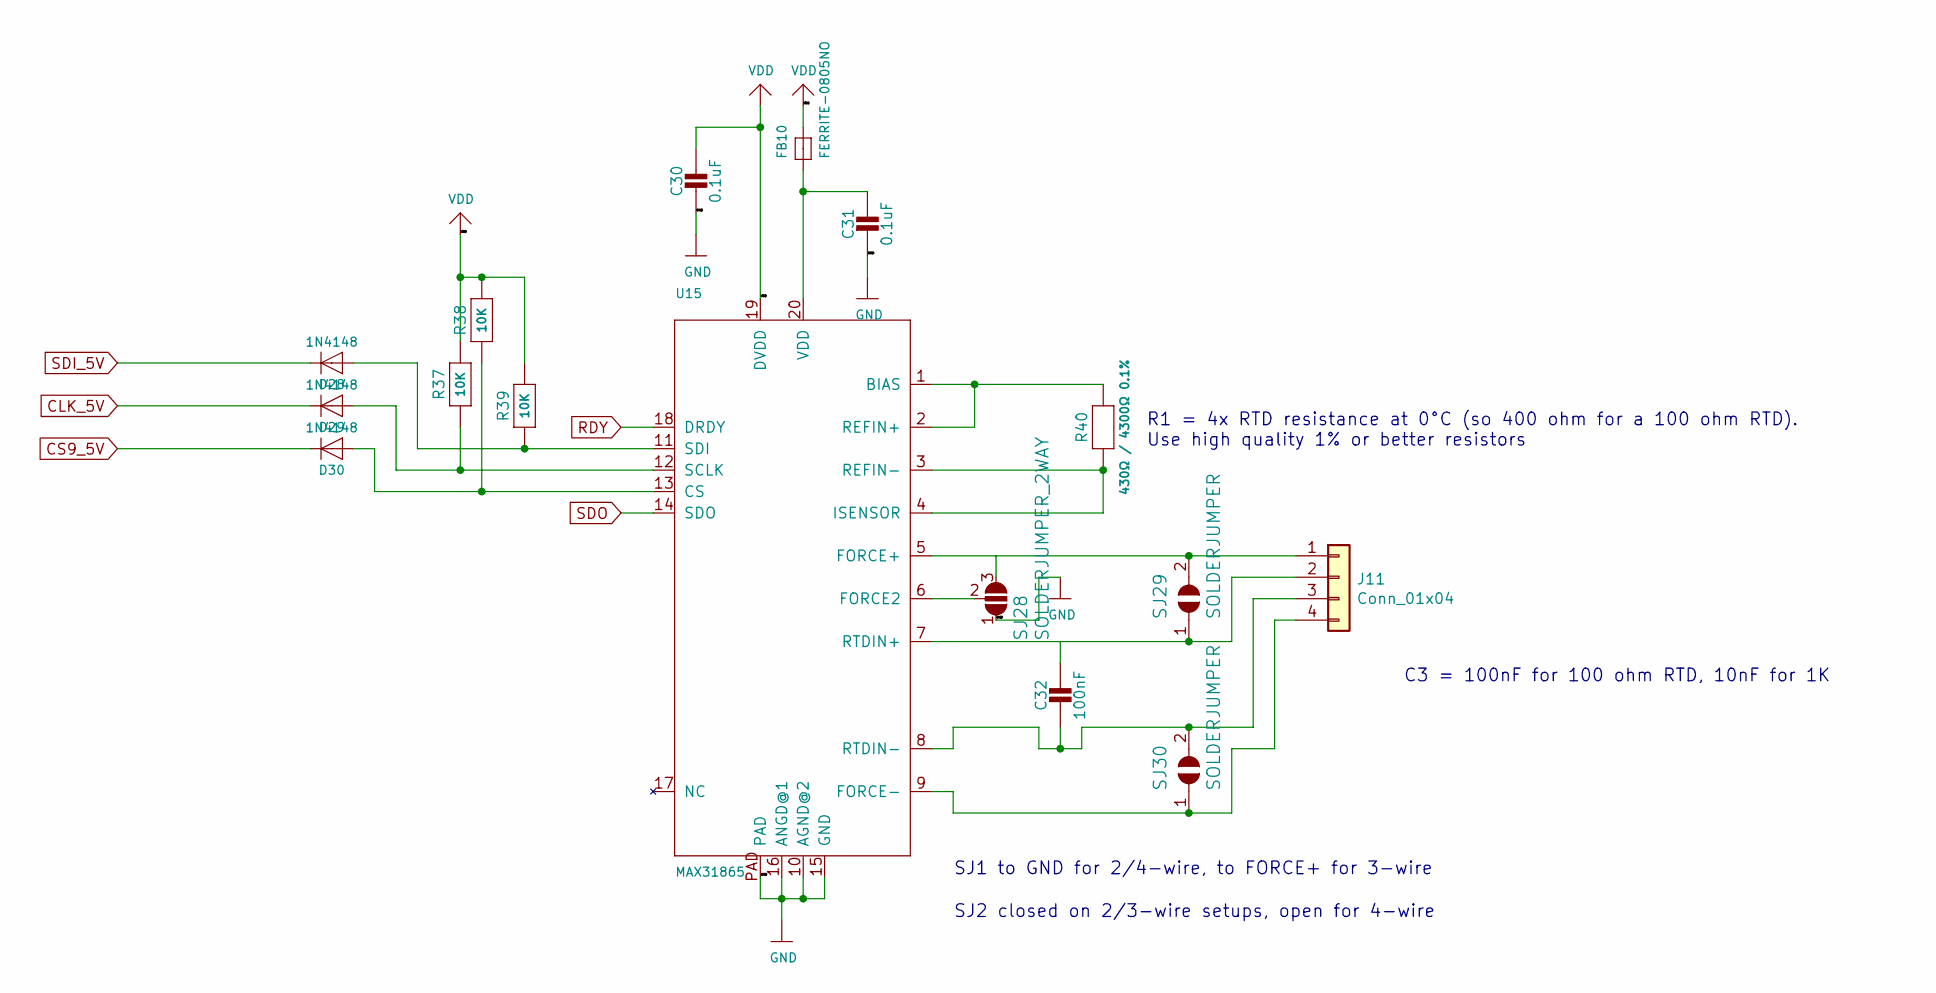
[picture p27: schematic max31865_09.sch]

Parts:
C30, C31: 0.1uF; 0805-NO
C32: 100nF; 0805-NO
D28, D29, D30: 1N4148; SOD-323
FB10: FERRITE-0805NO; 0805-NO
J11: Conn_01x04; TerminalBlock_4Ucon_1x04_P3.50mm_Horizontal
R37, R38, R39: 10K; 0805-NO
R40: 430Ω / 4300Ω 0.1%; 0805-NO
SJ28: SOLDERJUMPER_2WAY; SOLDERJUMPER_2WAY_OPEN_NOPASTE
SJ29, SJ30: SOLDERJUMPER; SOLDERJUMPER_ARROW_NOPASTE
U15: MAX31865; QFN20_4MM_0.65MM

Connections:
CLK_5V: D29.C; also elsewhere on the board
CS9_5V: D30.C; also elsewhere on the board
GND: C30.2, C31.2, SJ28.1, U15.10 (AGND@2), U15.15 (GND), U15.16 (ANGD@1), U15.PAD; also elsewhere on the board
unnamed: C31.1, FB10.1, U15.20 (VDD)
unnamed: C32.1, J11.2, SJ29.1, U15.7 (RTDIN+)
unnamed: C32.2, J11.3, SJ30.2, U15.8 (RTDIN-)
unnamed: D28.A, R39.1, U15.11 (SDI)
unnamed: D29.A, R37.1, U15.12 (SCLK)
unnamed: D30.A, R38.1, U15.13 (CS)
unnamed: J11.1, SJ28.3, SJ29.2, U15.5 (FORCE+)
unnamed: J11.4, SJ30.1, U15.9 (FORCE-)
unnamed: R40.1, U15.3 (REFIN-), U15.4 (ISENSOR)
unnamed: R40.2, U15.1 (BIAS), U15.2 (REFIN+)
unnamed: SJ28.2, U15.6 (FORCE2)
RDY: U15.18 (DRDY); also elsewhere on the board
SDI_5V: D28.C; also elsewhere on the board
SDO: U15.14 (SDO); also elsewhere on the board
VDD: C30.1, FB10.2, R37.2, R38.2, R39.2, U15.19 (DVDD); also elsewhere on the board

Notes on the sheet:
C3 = 100nF for 100 ohm RTD, 10nF for 1K
R1 = 4x RTD resistance at 0°C (so 400 ohm for a 100 ohm RTD). Use high quality 1% or better resistors
SJ1 to GND for 2/4-wire, to FORCE+ for 3-wire
SJ2 closed on 2/3-wire setups, open for 4-wire

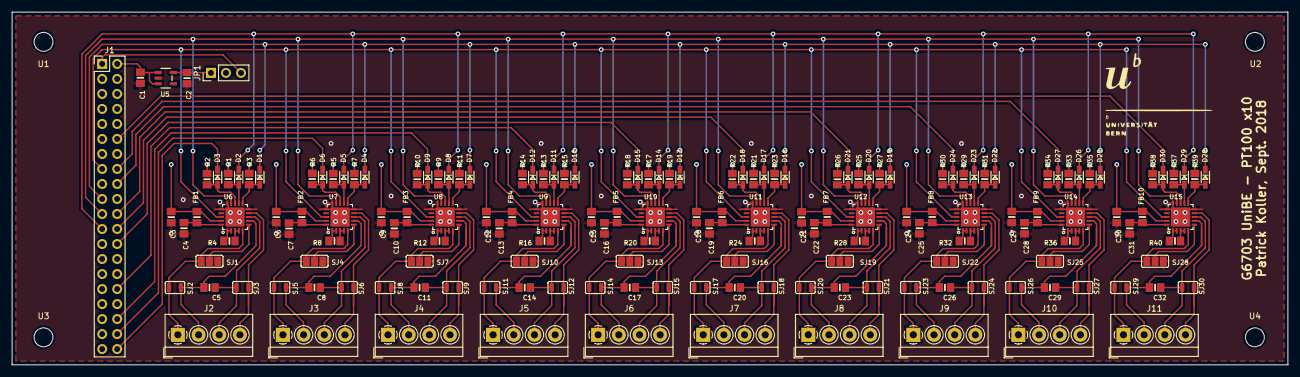
[picture p28: board MAX31865_x10_PCB.kicad_pcb from above]

Board: 2 copper layers, 215.9 x 59.7 mm, 169 parts (0 on the bottom side), 128 nets.
