PPKoller/MAX31865x10/MAX31865_x10_PCB/Adafruit MAX31865.kicad_pcb

## KiCad design MAX31865_x10_PCB/Adafruit MAX31865.kicad_pcb (2020-02-25)

Schematic: Adafruit MAX31865.sch

Parts:
C1, C2: 0.1uF; 0805-NO
C3: 100nF; 0805-NO
C4, C5: 10uF; 0805-NO
D1, D2, D3: 1N4148; SOD-323
FB1: FERRITE-0805NO; 0805-NO
FID1, FID2: FIDUCIAL\"\"; FIDUCIAL_1MM
JP1: HEADER-1X870MIL; 1X08_ROUND_70
R1: 430Ω / 4300Ω 0.1%; 0805-NO
R6, R7, R8: 10K; 0805-NO
SJ1: SOLDERJUMPER_2WAY; SOLDERJUMPER_2WAY_OPEN_NOPASTE
SJ3, SJ4: SOLDERJUMPER; SOLDERJUMPER_ARROW_NOPASTE
U1: MAX31865; QFN20_4MM_0.65MM
U3: MIC5225-3.3; SOT23-5
U$18, U$19: MOUNTINGHOLE2.5; MOUNTINGHOLE_2.5_PLATED
X1, X2: 3.5mm; TERMBLOCK_1X2-3.5MM

Connections:
/CS_5V: D3.C, JP1.7
/DRDY: JP1.8, U1.18 (DRDY)
/SCLK_5V: D2.C, JP1.4
/SDI_5V: D1.C, JP1.6
/SDO: JP1.5, U1.14 (SDO)
GND: C1.2, C2.2, C4.2, C5.2, JP1.2, SJ1.1, U1.10 (AGND@2), U1.15 (GND), U1.16 (ANGD@1), U1.PAD, U3.2 (GND)
unnamed: C2.1, FB1.1, U1.20 (VDD)
unnamed: C3.1, SJ3.1, U1.7 (RTDIN+), X1.1
unnamed: C3.2, SJ4.2, U1.8 (RTDIN-), X2.2
unnamed: D1.A, R6.1, U1.11 (SDI)
unnamed: D2.A, R8.1, U1.12 (SCLK)
unnamed: D3.A, R7.1, U1.13 (CS)
unnamed: R1.1, U1.3 (REFIN-), U1.4 (ISENSOR)
unnamed: R1.2, U1.1 (BIAS), U1.2 (REFIN+)
unnamed: SJ1.2, U1.6 (FORCE2)
unnamed: SJ1.3, SJ3.2, U1.5 (FORCE+), X1.2
unnamed: SJ4.1, U1.9 (FORCE-), X2.1
VDD: C1.1, C5.1, FB1.2, JP1.3, R6.2, R7.2, R8.2, U1.19 (DVDD), U3.5 (OUT)
VIN: C4.1, JP1.1, U3.1 (IN), U3.3 (EN)

Notes on the sheet:
C3 = 100nF for 100 ohm RTD, 10nF for 1K
R1 = 4x RTD resistance at 0°C (so 400 ohm for a 100 ohm RTD). Use high quality 1% or better resistors
SJ1 to GND for 2/4-wire, to FORCE+ for 3-wire
SJ2 closed on 2/3-wire setups, open for 4-wire

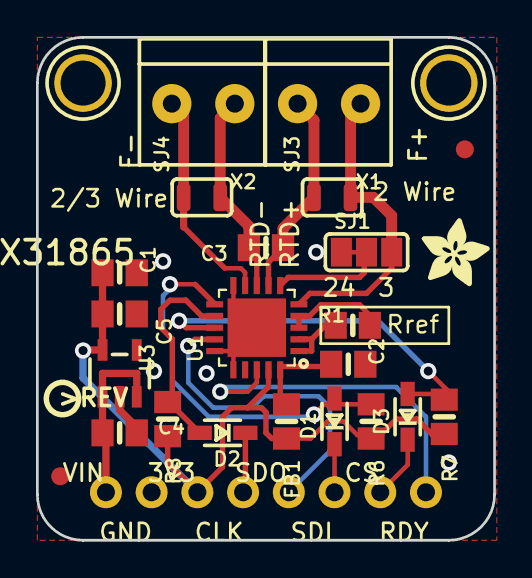
[picture p29: board Adafruit MAX31865.kicad_pcb from above]

Board: 2 copper layers, 25.4 x 27.9 mm, 29 parts (0 on the bottom side), 19 nets.

Other parts of the board:
U$8: PCBFEAT-REV-040
U$16: ADAFRUIT_3.5MM
U$20, U$21: ADAFRUIT_5MM
